OlgunErdogan/Converting_Falcons/README.md

# Converting_Falcons
Hardware project repository based on the elbow grease of converting falcons.
https://youtu.be/T0_olXNja7c
