OlgunErdogan/Converting_Falcons/(commit log)

2018-01-18 Overall schematic is added
2018-01-26 Arduino code is added
